rakibsta/LEAN_CAR/MPU6050_noise2.png

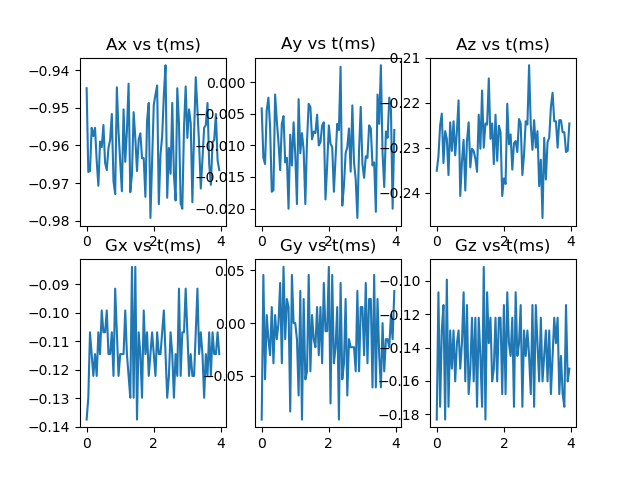
MPU6050_noise2.png
