rakibsta/LEAN_CAR/MPU6050_noise.png

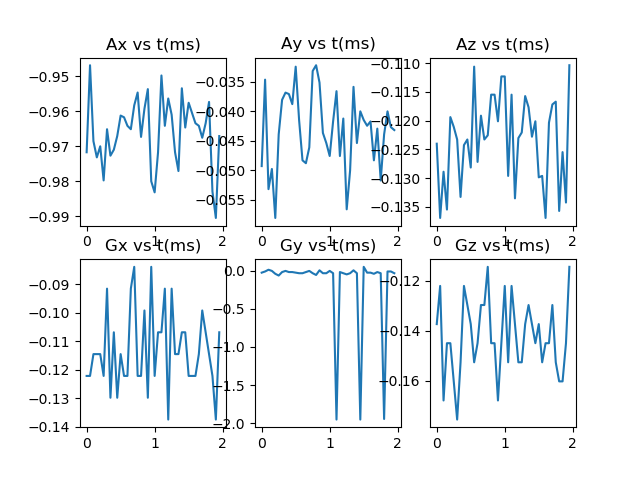
MPU6050_noise.png
