rakibsta/LEAN_CAR/CAD Files/PI-mount_1.stl

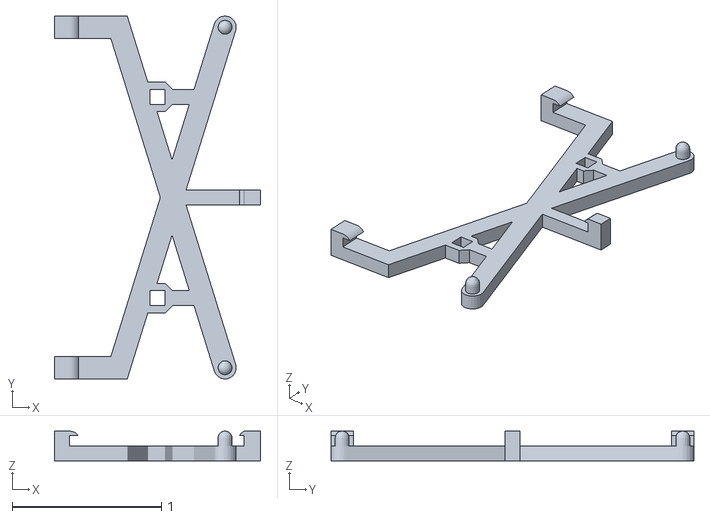
[picture p7: CAD file, 2023-02-14]
CAD Files/PI-mount_1.stl
1.38 x 2.43 x 0.2
