rakibsta/LEAN_CAR/CAD Files/tyre_inner4.stl

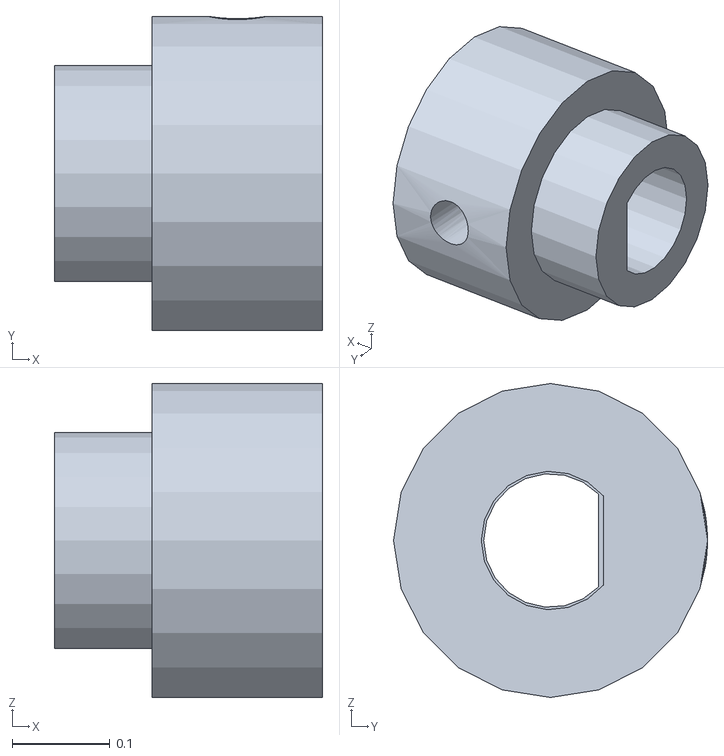
[picture p8: CAD file, 2023-02-14]
CAD Files/tyre_inner4.stl
0.275 x 0.322 x 0.322
