rakibsta/LEAN_CAR/CAD Files/PI-mount.stl

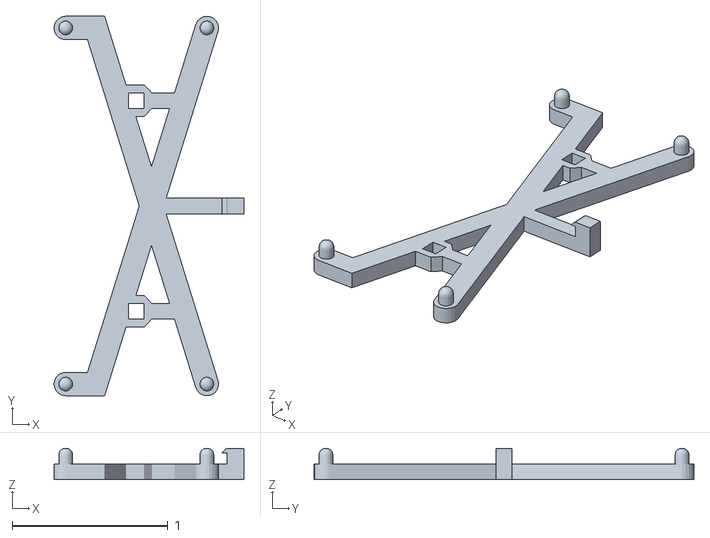
[picture p9: CAD file, 2023-02-14]
CAD Files/PI-mount.stl
1.22 x 2.43 x 0.2
