rakibsta/LEAN_CAR/CAD Files/LEAN_new_1.stl

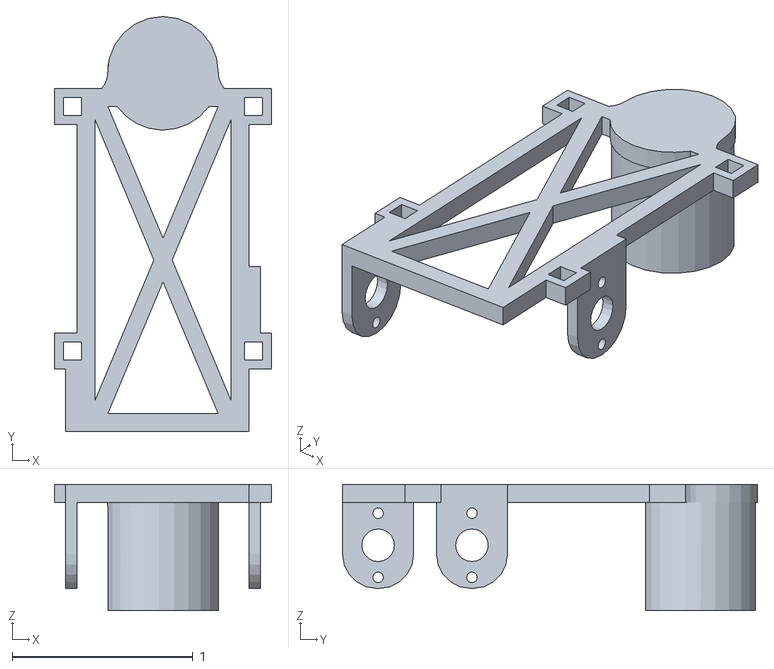
[picture p10: CAD file, 2023-02-14]
CAD Files/LEAN_new_1.stl
1.20 x 2.29 x 0.697
