rakibsta/LEAN_CAR/CAD Files/tyre_outer - Copy.stl

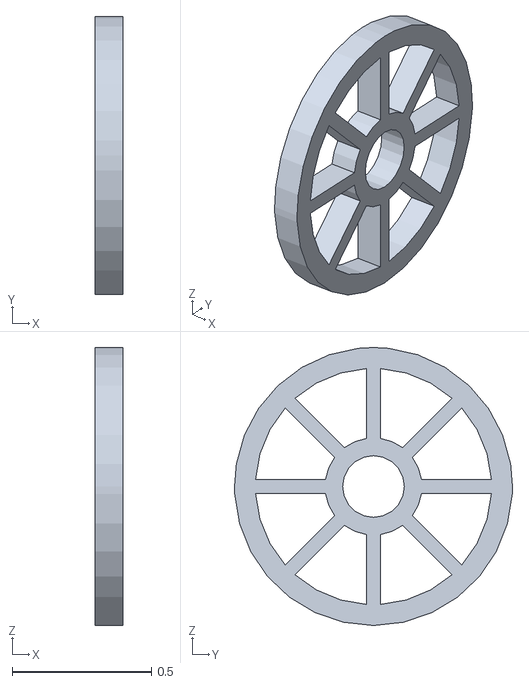
[picture p11: CAD file, 2023-02-14]
CAD Files/tyre_outer - Copy.stl
0.1 x 1 x 1
