rakibsta/LEAN_CAR/(commit log)

2022-07-26 sensor test code
2022-07-26 sensor code
